Joseee-ctrl/KRAKEN-PCB/Esquematicos_Kraken/fotokraken.png

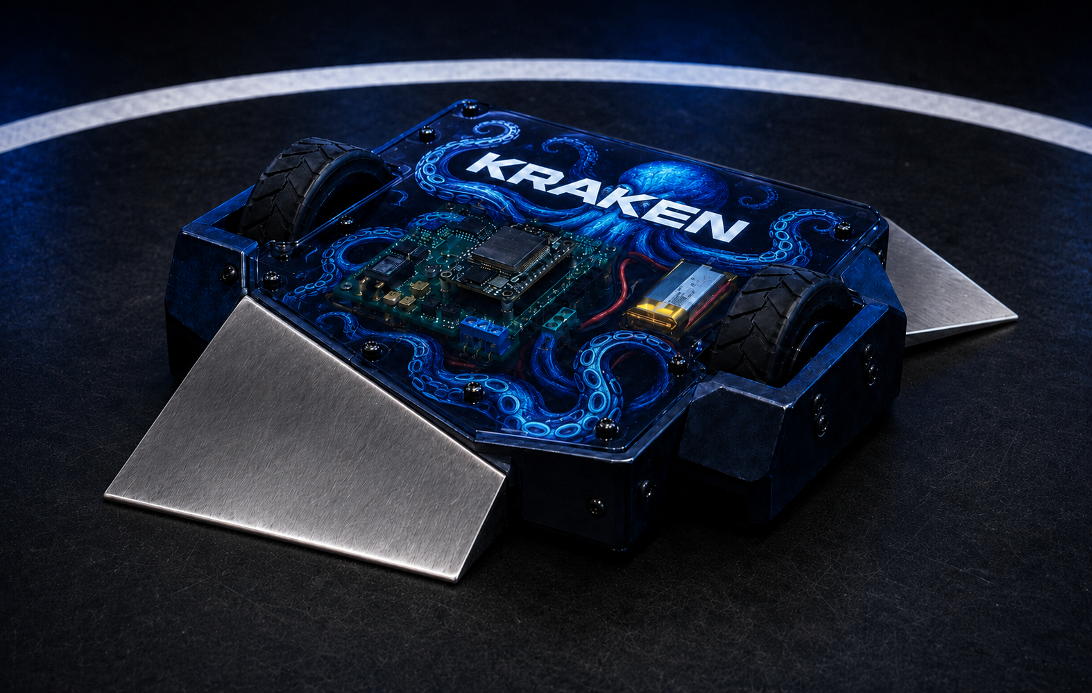
Esquematicos_Kraken/fotokraken.png
