Joseee-ctrl/KRAKEN-PCB/Esquematicos_Kraken/Calculos_esquematicos_pdfs/Reporte_PCB_Kraken.pdf

## Diseño de PCB - Robot Sumo Kraken

Simulación de Circuitos y PCB

Jose Martínez
Carné: 24050

Septiembre de 2026

## 1. Introducción

En esta etapa se realizó el diseño final de la PCB del robot sumo Kraken en Altium Designer. El diseño parte de los esquemáticos desarrollados previamente para los módulos de potencia, control BLE y driver de motores. En este documento se presentan únicamente las decisiones principales del layout, las reglas de fabricación, la verificación y los archivos de salida, evitando repetir la descripción completa de los esquemáticos.

## 2. Diseño de la PCB

La placa final tiene dimensiones de aproximadamente 105 mm × 75 mm. Los componentes se distribuyeron buscando recorridos simples entre alimentación, control y motores. Todo el ruteo se realizó en Bottom Layer, siguiendo la recomendación de fabricación para facilitar el proceso de soldadura. También se agregaron cuatro puntos de montaje de 3 mm en las esquinas.

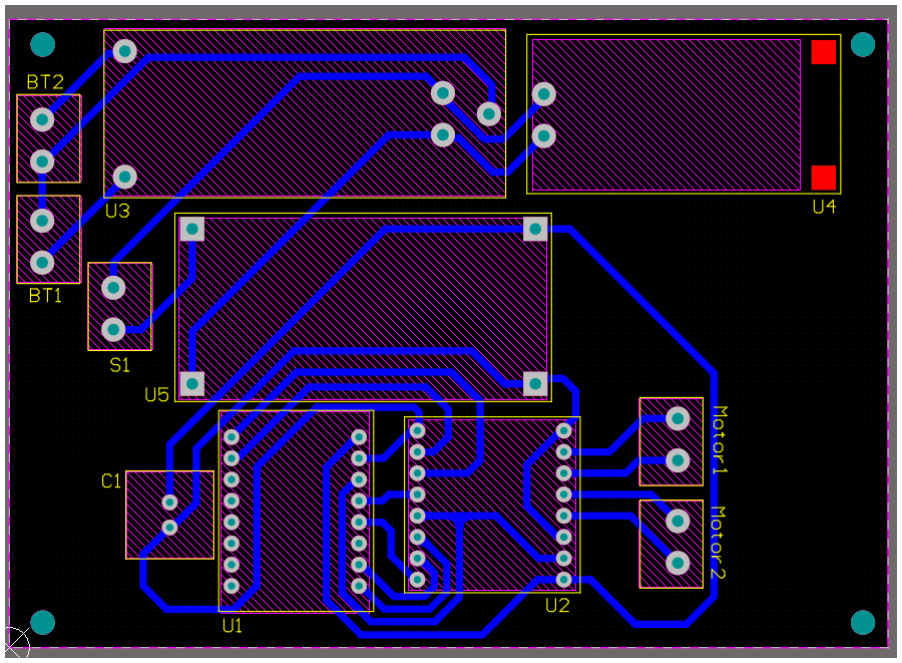
[picture p22: figure]

Figura 1: Layout final de la PCB del robot Kraken.

Todos los footprints incluyen arte en silkscreen y se verificó la posición de los módulos mediante sus modelos 3D. La vista 3D permitió comprobar la orientación de conectores, borneras y módulos antes de generar los archivos de fabricación.

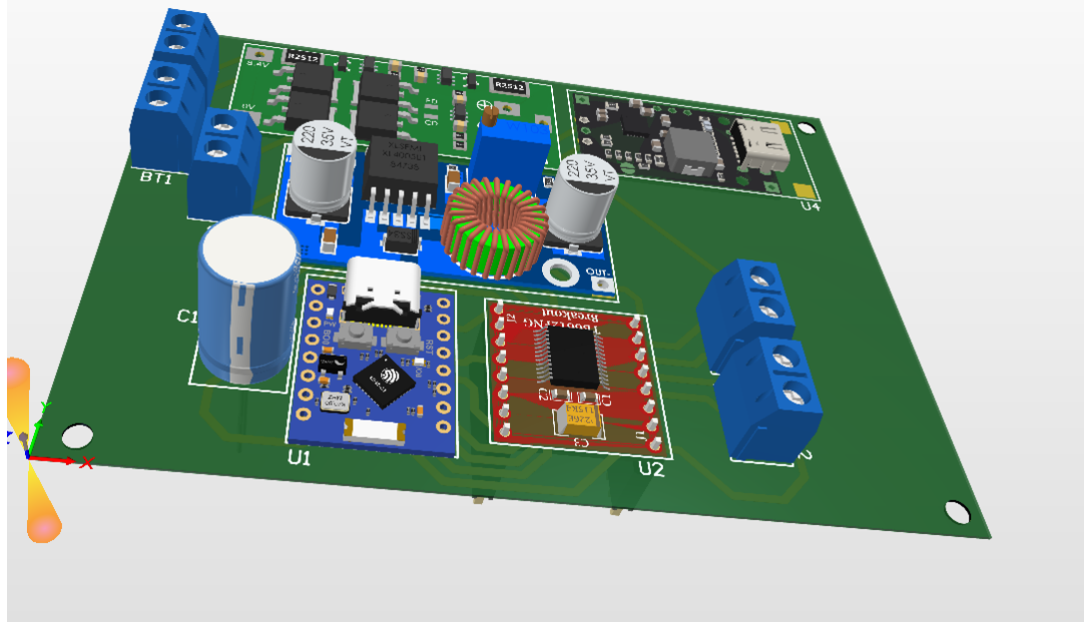
[picture p23: figure]

Figura 2: Vista 3D del diseño final.

## 3. Reglas de diseño

Las reglas se configuraron de acuerdo con los requerimientos del proyecto y con las especificaciones de la fresadora ProtoMat S103. La Tabla 1 resume los valores principales utilizados.

Cuadro 1: Reglas principales del diseño.

Parámetro | Valor utilizado
Dimensiones de la placa | 105 mm × 75 mm
Ancho de pista | 1.0 mm (≈ 39.4 mil)
Clearance | 0.508 mm
Anillo anular mínimo | 0.254 mm
Agujeros de componentes | 1.0 mm y 1.5 mm
Agujeros de montaje | 3.0 mm, NPTH
Capas de ruteo | Bottom Layer

El ancho de 1.0 mm se mantuvo en las pistas del diseño para facilitar la fabricación y soldadura, además de proporcionar margen respecto a los mínimos calculados para las corrientes del sistema.

## 4. Cálculo de ancho de pista

Se utilizó la calculadora ANSI PCB Trace Width basada en IPC-2221A, considerando cobre de 1 oz y un aumento máximo de temperatura de 10◦C.

Para una corriente de 1 A, correspondiente al caso de un motor, el ancho requerido para una pista externa fue de 12.13 mil (≈ 0.31 mm).

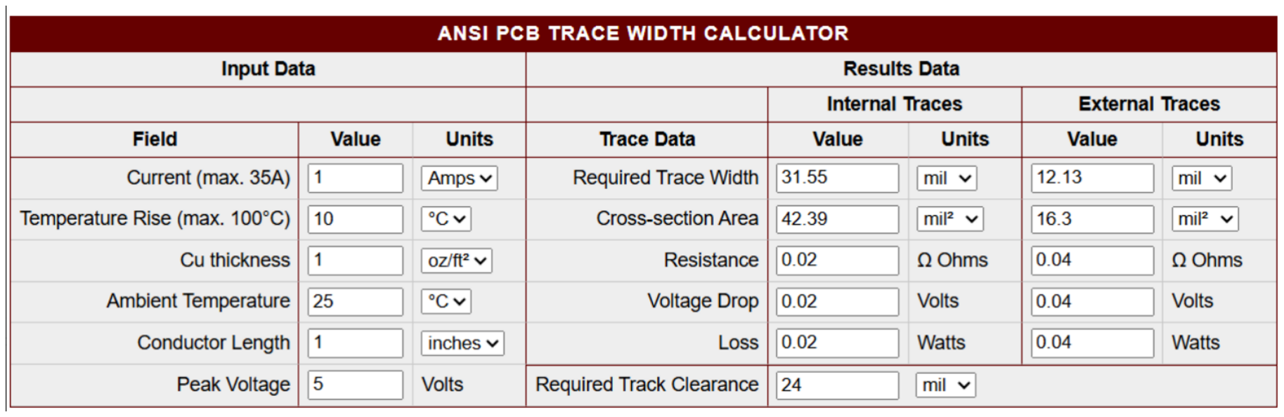
[picture p24: figure]

Figura 3: Cálculo de ancho de pista para 1 A.

Para una corriente de 2 A, utilizada como caso de alimentación común, el ancho requerido fue de 31.55 mil (≈ 0.80 mm). Por lo tanto, el ancho utilizado de 1.0 mm cumple con ambos casos.

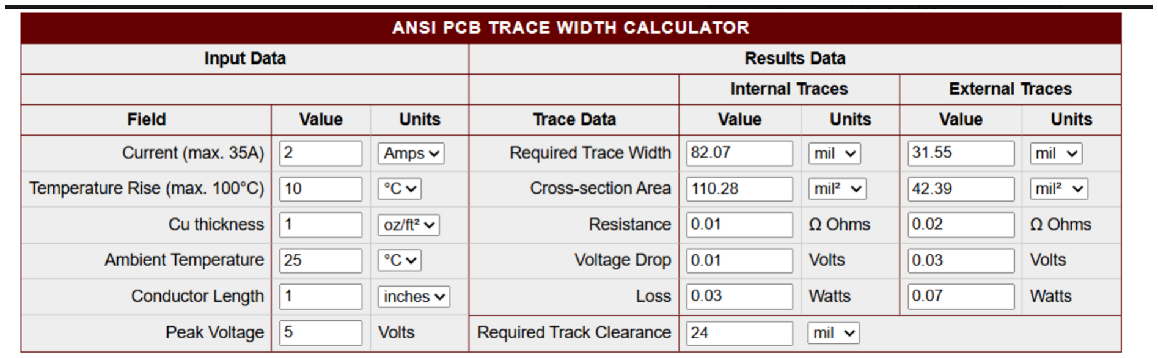
[picture p25: figure]

Figura 4: Cálculo de ancho de pista para 2 A.

## 5. Verificación del diseño

Después de finalizar el ruteo y agregar los puntos de montaje se ejecutó el Design Rule Check de Altium Designer. El reporte final mostró 0 warnings y 0 rule violations, confirmando que el diseño cumple las reglas configuradas de clearance, ancho de pista, agujeros y manufactura.

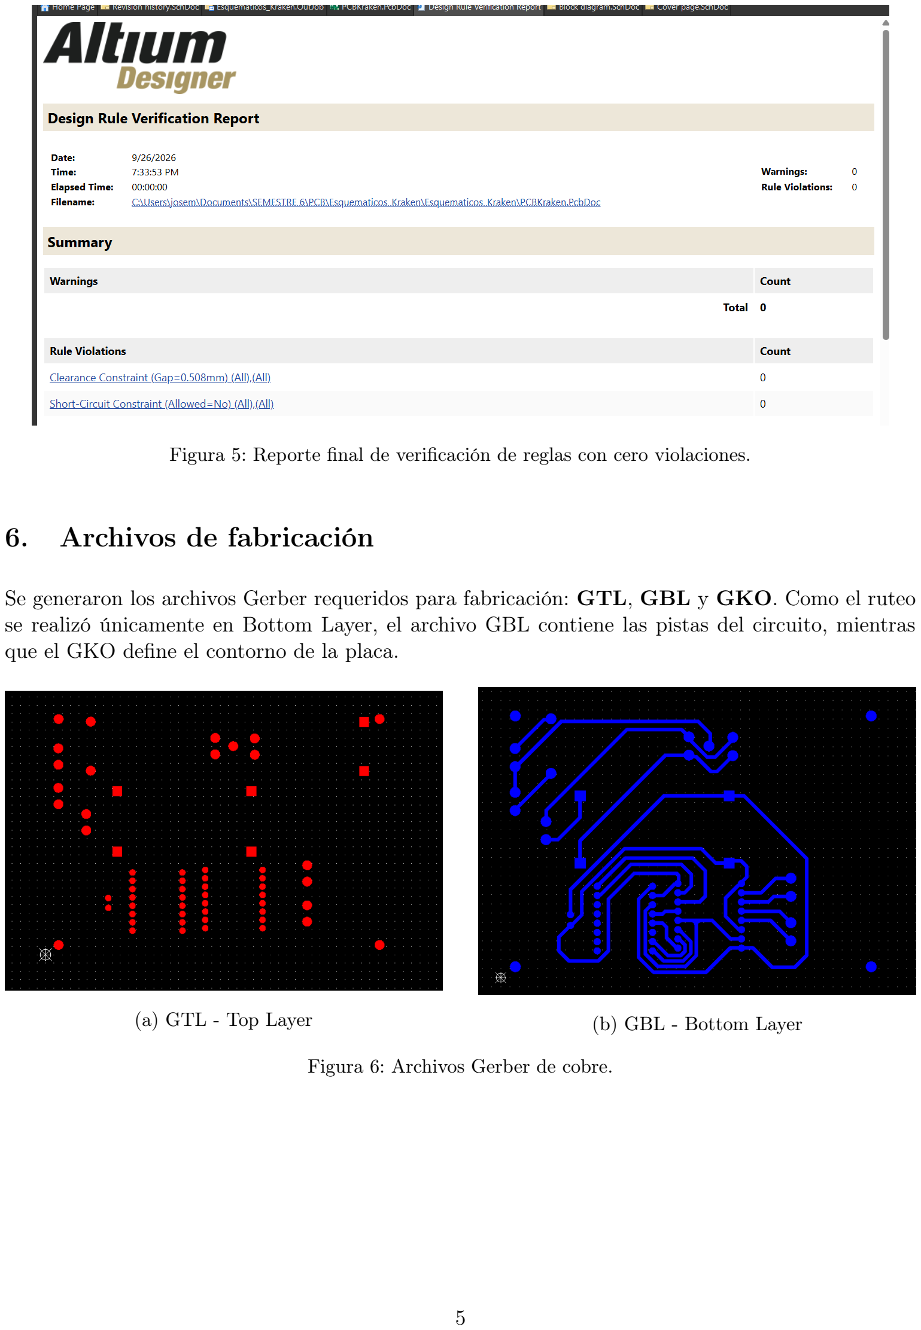
[picture p26: page 5]

Figura 5: Reporte final de verificación de reglas con cero violaciones.

## 6. Archivos de fabricación

Se generaron los archivos Gerber requeridos para fabricación: GTL, GBL y GKO. Como el ruteo se realizó únicamente en Bottom Layer, el archivo GBL contiene las pistas del circuito, mientras que el GKO define el contorno de la placa.

(a) GTL - Top Layer | (b) GBL - Bottom Layer

Figura 6: Archivos Gerber de cobre.

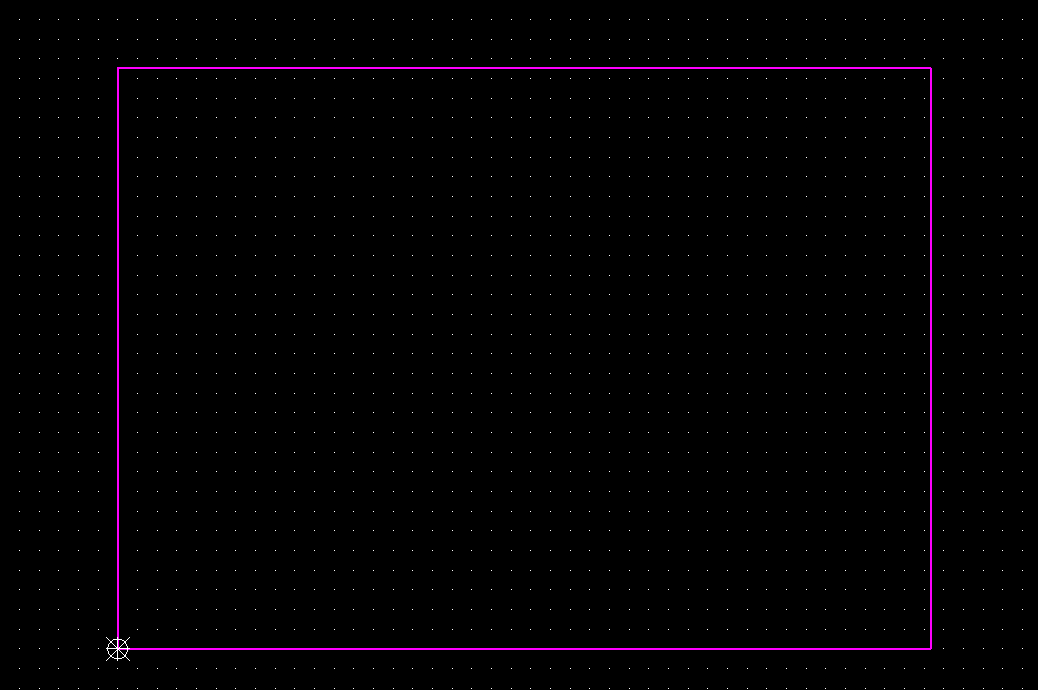
[picture p27: figure]

Figura 7: Archivo GKO con el contorno de la placa.

También se generaron dos archivos NC Drill separados: uno para los agujeros metalizados de los componentes y otro para los agujeros de montaje no metalizados.

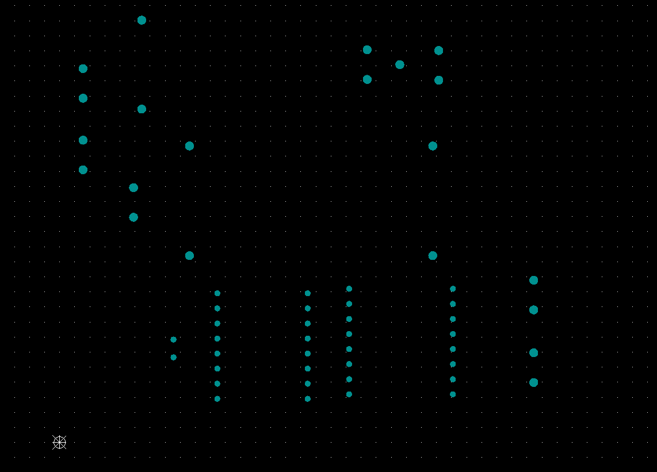
[picture p28: figure]

(a) Agujeros plated

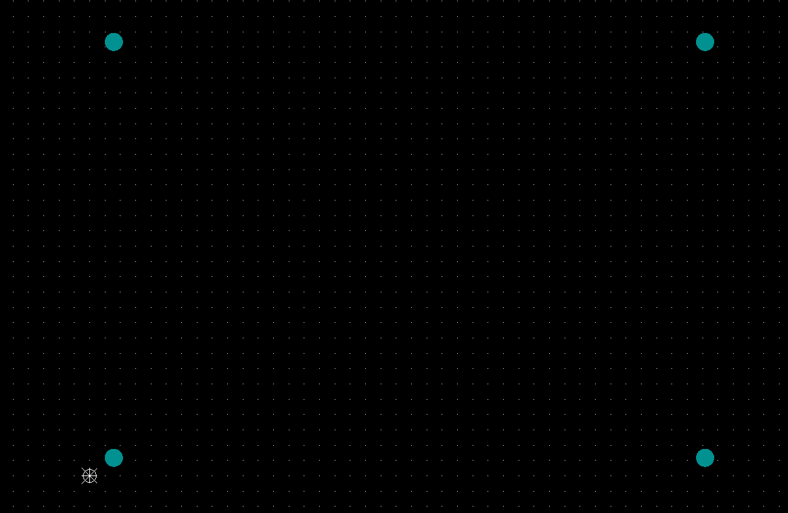
[picture p29: figure]

(b) Agujeros NPTH de montaje

Figura 8: Archivos NC Drill del diseño.

## 7. Encapsulado propuesto

La PCB se montará dentro del chasis del robot utilizando los cuatro puntos de montaje agregados en las esquinas. Se utilizarán separadores para evitar que las soldaduras de la cara inferior tengan contacto con la estructura. El montaje deberá mantener accesibles las borneras, el interruptor y el conector USB-C del cargador.

## 8. Conclusiones

Se completó el diseño final de la PCB del robot Kraken con ruteo en una sola cara, footprints con modelos 3D y reglas adaptadas a la ProtoMat S103. Los cálculos de ancho de pista justifican el valor utilizado y el DRC final no presentó violaciones. Finalmente, se generaron los archivos Gerber y NC Drill requeridos para fabricación.

## Referencias

1. Universidad del Valle de Guatemala. IE3028 - Proyecto de Curso, 2026.
2. Universidad del Valle de Guatemala. Especificaciones LPKF ProtoMat S103.
3. ANSI IPC-2221A PCB Trace Width Calculator.
4. Esquemáticos Kraken, documentación previa del proyecto.
