Joseee-ctrl/KRAKEN-PCB/Esquematicos_Kraken/Project Outputs for Esquematicos_Kraken/Esquematicos_Kraken.xls

Sheet: BOM Report
Bill of Materials |  |  | Bill of Materials for BOM Document [Esquematicos_Kraken.BomDoc]
Source Data From: |  | Esquematicos_Kraken.BomDoc
Project: |  | Esquematicos_Kraken.PrjPcb
Variant: |  | None
Creation Date: | 9/7/2026 | 10:59 AM
Print Date: | 2026-09-07 | 11:00:01
Footprint | Name | LibRef | Designator | Description | Quantity
BAT-2 | Battery | Battery | BT1, BT2 | Multicell Battery | 2
RB7.6-15 | Cap Pol1 | Cap Pol1 | C1 | Polarized Capacitor (Radial) | 1
RAD-0.3 | Cap | Cap | C2, C3 | Capacitor | 2
RB5-10.5 | Motor | Motor | M1, M2 | Motor N20 6V 300 RPM | 2
SPST-2 | SW-SPST | SW-SPST | S1 | Single-Pole, Single-Throw Switch | 1
 | ESP32-C3 SUPERMINI | ESP32-C3 SUPERMINI | U1 | ESP32-C3 SUPERMINI V1.0 | 1
 | TB6612FNG devkit v1.0 | TB6612FNG devkit v1.0 | U2 | TB6612FNG devkit v1.0 | 1
 | BMS 2S 20A | BMS 2S 20A | U3 | BMS 2S 20A v1.0 | 1
 | CARGADOR 2S USB-C | CARGADOR 2S USB-C | U4 | CARGADOR 2S USB-C v1.0 | 1
 | XL4005 | XL4005_MODULE | U5 | XL4005_MODULE | 1
 |  |  |  |  | 13
Approved |  | Notes

Sheet: Project Information
Project Full Path | C:\Users\josem\Documents\SEMESTRE 6\PCB\Esquematicos_Kraken\Esquematicos_Kraken\Esquematicos_Kraken.PrjPcb
Project Filename | Esquematicos_Kraken.PrjPcb
Variant Name | None
Data-Source Filename | Esquematicos_Kraken.BomDoc
Data-Source Full Path | C:\Users\josem\Documents\SEMESTRE 6\PCB\Esquematicos_Kraken\Esquematicos_Kraken\Esquematicos_Kraken.BomDoc
Title | Bill of Materials for BOM Document [Esquematicos_Kraken.BomDoc]
Total Quantity | 13
Report Time | 10:59 AM
Report Date | 9/7/2026
Report Date & Tine | 9/7/2026 10:59 AM
Output Name | Bill of Materials
Output Type | BomReport
Output Generator Name | BOM
Output Generator Description | Bill of Materials
