Joseee-ctrl/KRAKEN-PCB/Esquematicos_Kraken/Project Outputs for Esquematicos_Kraken/Esquematicos_Kraken.xlsx

Name | Description | Designator | LibRef | Supplier | Value | SKU | Precio unitario (Q)
Battery | Multicell Battery | BT1, BT2 | Battery | DIY ELECTRONICA |  | T35 | 55
Cap Pol1 | Polarized Capacitor (Radial) | C1 | Cap Pol1 | DIY ELECTRONICA | 1000uF | K510-1 | 4.5
Cap | Capacitor | C2, C3 | Cap | DIY ELECTRONICA | 100nF | K305-1 | 0.5
Motor | Motor N20 6V 300 RPM | M1, M2 | Motor | DIY ELECTRONICA |  | M225 | 44
SW-SPST | Single-Pole, Single-Throw Switch | S1 | SW-SPST | DIY ELECTRONICA |  | M234 | 6
ESP32-C3 SUPERMINI | ESP32-C3 SUPERMINI V1.0 | U1 | ESP32-C3 SUPERMINI | DIY ELECTRONICA |  | B207 | 75
TB6612FNG devkit v1.0 | TB6612FNG devkit v1.0 | U2 | TB6612FNG devkit v1.0 | DIY ELECTRONICA |  | I235 | 45
BMS 2S 20A | BMS 2S 20A v1.0 | U3 | BMS 2S 20A | DIY ELECTRONICA |  | I239 | 29.5
CARGADOR 2S USB-C | CARGADOR 2S USB-C v1.0 | U4 | CARGADOR 2S USB-C | DIY ELECTRONICA |  | I232 | 15
XL4005 | XL4005_MODULE | U5 | XL4005_MODULE | DIY ELECTRONICA |  | I26 | 30
