Joseee-ctrl/KRAKEN-PCB/Esquematicos_Kraken/modelo/paredes 2 kraken.dxf

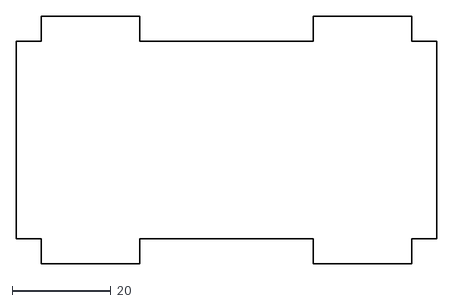
[picture p30: CAD file, 2026-10-31]
Esquematicos_Kraken/modelo/paredes 2 kraken.dxf
85.0 x 50.0
