Joseee-ctrl/KRAKEN-PCB/Esquematicos_Kraken/Steps/XL4005_MODELO_3D_1.step

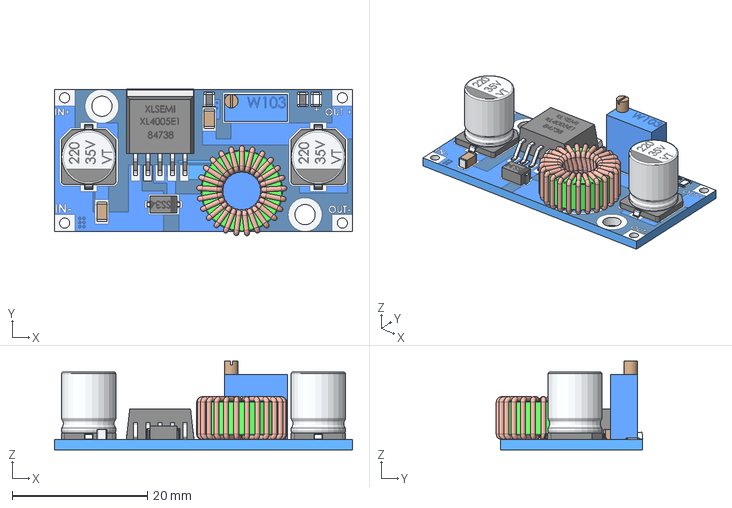
[picture p31: CAD file, 2026-10-31]
Esquematicos_Kraken/Steps/XL4005_MODELO_3D_1.step
44.0 x 21.6 x 13.1 mm
