Joseee-ctrl/KRAKEN-PCB/Esquematicos_Kraken/modelo/cuñas kraken.dxf

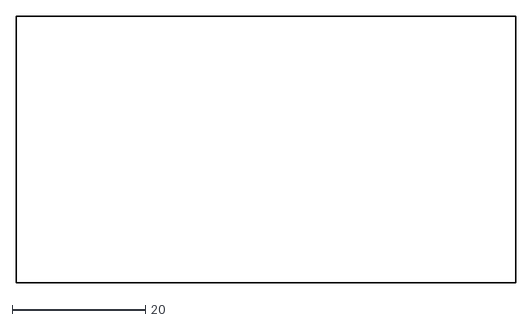
[picture p32: CAD file, 2026-10-31]
Esquematicos_Kraken/modelo/cuñas kraken.dxf
75.0 x 40.0
