Joseee-ctrl/KRAKEN-PCB/Esquematicos_Kraken/Steps/Terminal block 5mm.step

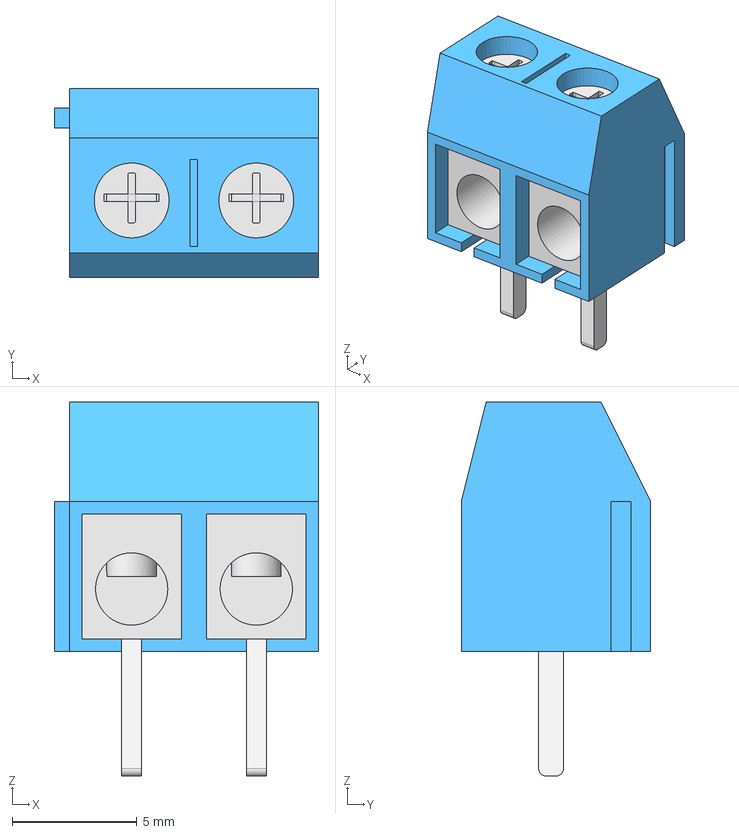
[picture p33: CAD file, 2026-10-31]
Esquematicos_Kraken/Steps/Terminal block 5mm.step
10.6 x 7.60 x 15.0 mm
Tornillos001
