Joseee-ctrl/KRAKEN-PCB/Esquematicos_Kraken/modelo/baseNUEVAkraken.dxf

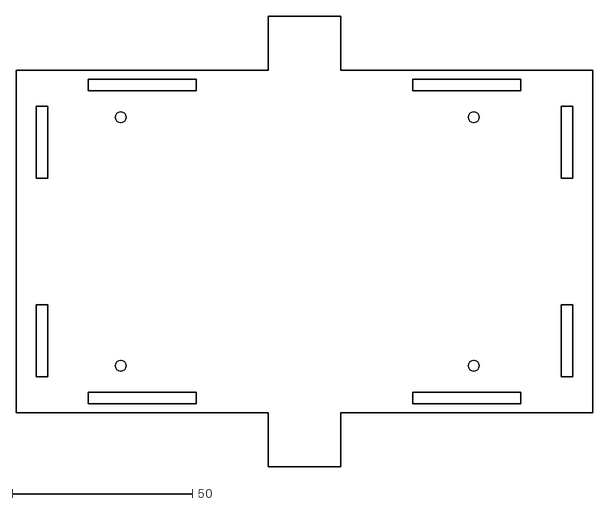
[picture p34: CAD file, 2026-10-31]
Esquematicos_Kraken/modelo/baseNUEVAkraken.dxf
160.0 x 125.0
