Joseee-ctrl/KRAKEN-PCB/Esquematicos_Kraken/Steps/switch.step

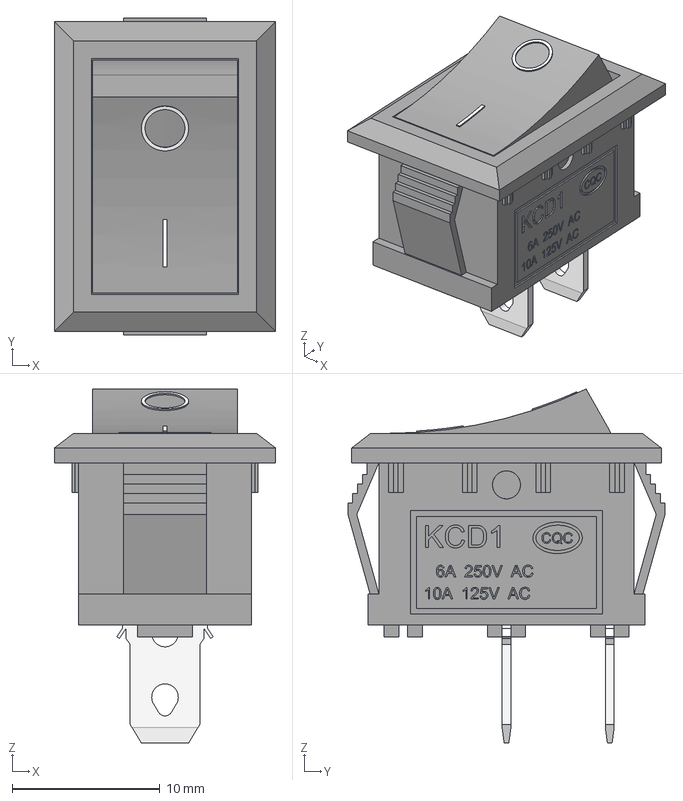
[picture p35: CAD file, 2026-10-31]
Esquematicos_Kraken/Steps/switch.step
15.0 x 21.5 x 24.0 mm
Blade_001
Blade_002
Base_w_text
knob001
