Joseee-ctrl/KRAKEN-PCB/Esquematicos_Kraken/modelo/paredes 1 kraken.dxf

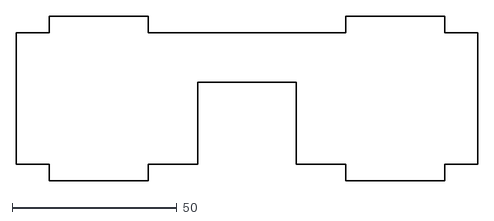
[picture p36: CAD file, 2026-10-31]
Esquematicos_Kraken/modelo/paredes 1 kraken.dxf
140.0 x 50.0
