Joseee-ctrl/KRAKEN-PCB/Esquematicos_Kraken/Steps/cargador2.step

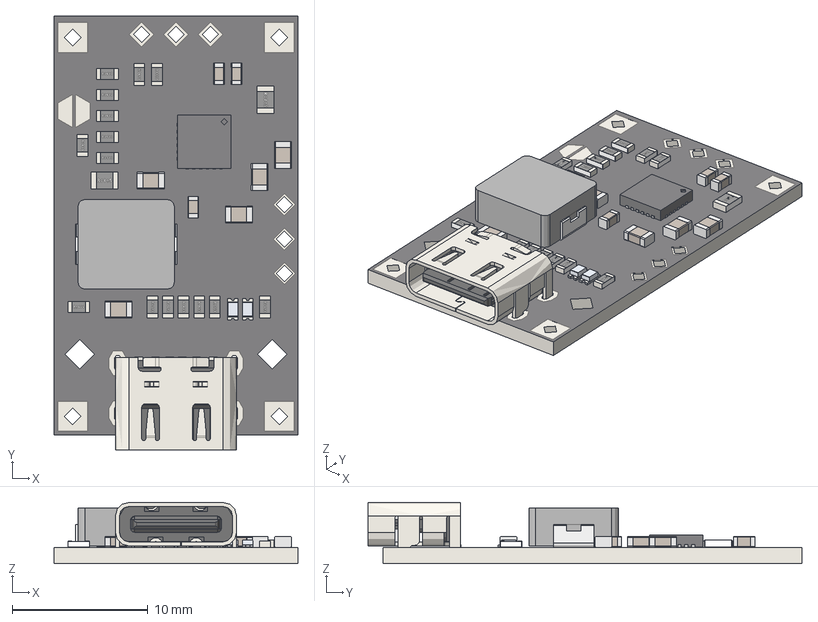
[picture p37: CAD file, 2026-10-31]
Esquematicos_Kraken/Steps/cargador2.step
18.0 x 32.0 x 4.51 mm
