Joseee-ctrl/KRAKEN-PCB/Esquematicos_Kraken/modelo/basekraken.dxf

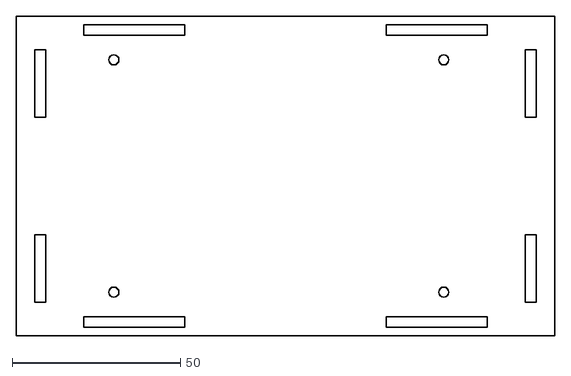
[picture p38: CAD file, 2026-10-31]
Esquematicos_Kraken/modelo/basekraken.dxf
160.0 x 95.0
