Joseee-ctrl/KRAKEN-PCB/Esquematicos_Kraken/Steps/TB6612FNG.step

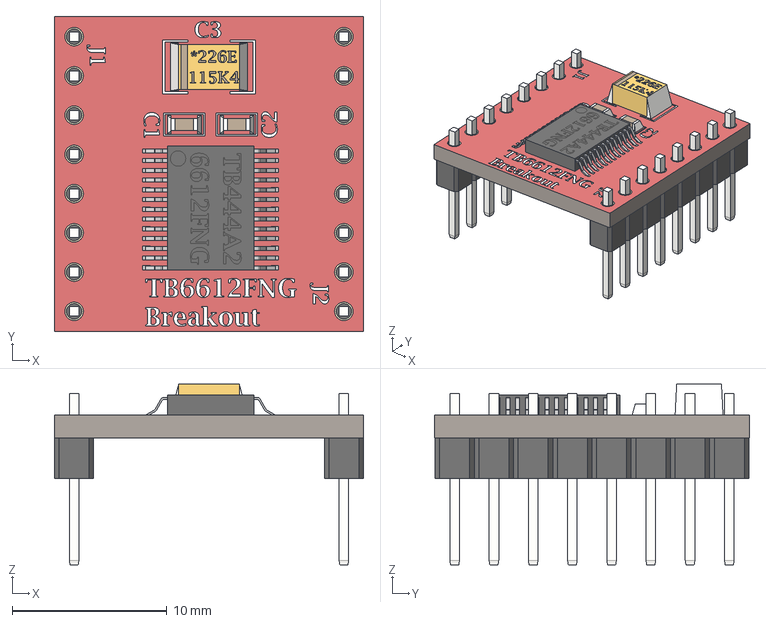
[picture p39: CAD file, 2026-10-31]
Esquematicos_Kraken/Steps/TB6612FNG.step
20.0 x 20.4 x 11.7 mm
8x1 male header pins x 2
