Joseee-ctrl/KRAKEN-PCB/Esquematicos_Kraken/modelo/cuñas Copy 1 - Part 1.dxf

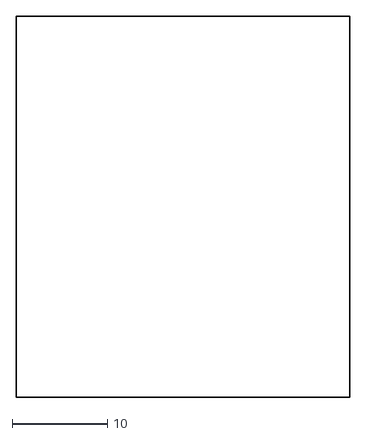
[picture p40: CAD file, 2026-10-31]
Esquematicos_Kraken/modelo/cuñas Copy 1 - Part 1.dxf
35.0 x 40.0
