Joseee-ctrl/KRAKEN-PCB/Esquematicos_Kraken/Steps/bornera2p.step

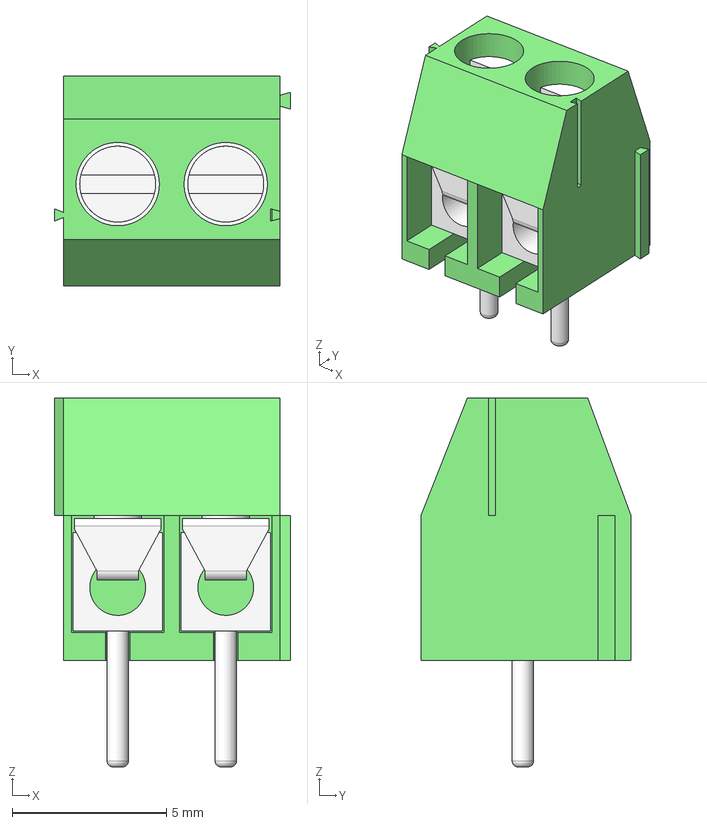
[picture p41: CAD file, 2026-10-31]
Esquematicos_Kraken/Steps/bornera2p.step
7.65 x 6.80 x 11.9 mm
Corps
Conn_1
Conn_2
blade_1
blade_2
Vis_1
Vis_001
