Joseee-ctrl/KRAKEN-PCB/Esquematicos_Kraken/Steps/HW-391 2S 20A BMS.step

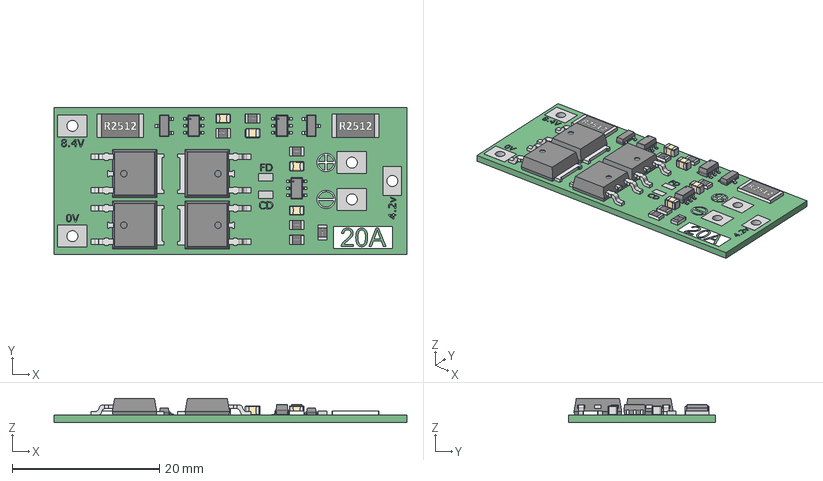
[picture p42: CAD file, 2026-10-31]
Esquematicos_Kraken/Steps/HW-391 2S 20A BMS.step
48.0 x 20.0 x 3.31 mm
