Joseee-ctrl/KRAKEN-PCB/Esquematicos_Kraken/Steps/ESP32-C3-SuperMini.step

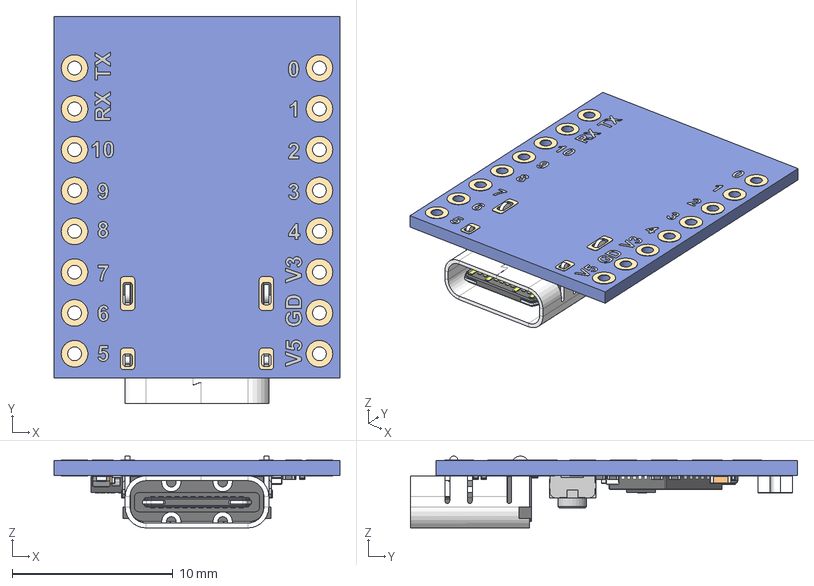
[picture p43: CAD file, 2026-10-31]
Esquematicos_Kraken/Steps/ESP32-C3-SuperMini.step
17.8 x 24.1 x 4.47 mm
