Joseee-ctrl/KRAKEN-PCB/Esquematicos_Kraken/Steps/100uF electrolytic capacitor.step

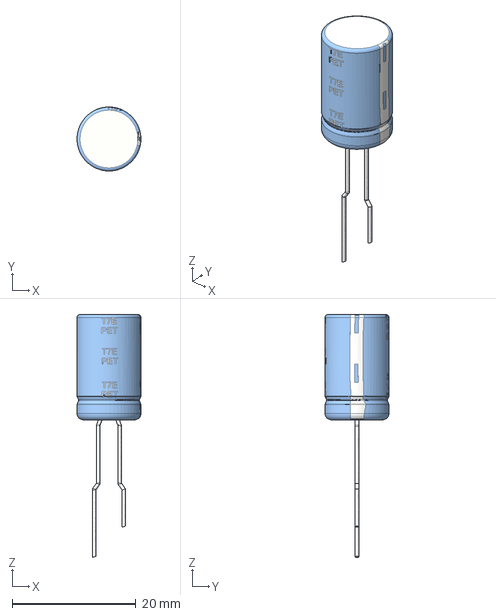
[picture p44: CAD file, 2026-10-31]
Esquematicos_Kraken/Steps/100uF electrolytic capacitor.step
10.3 x 10.3 x 39.3 mm
