Joseee-ctrl/KRAKEN-PCB/Esquematicos_Kraken/modelo/krakenprueba1.pdf

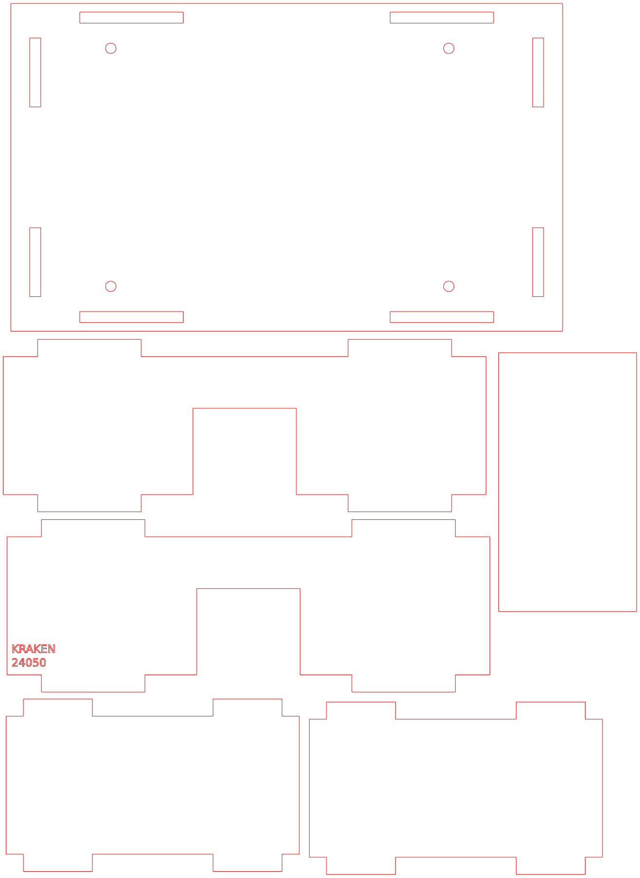
[picture p54: figure]
