Joseee-ctrl/KRAKEN-PCB/Esquematicos_Kraken/Calculos_esquematicos_pdfs/Esquematicos_Kraken.pdf

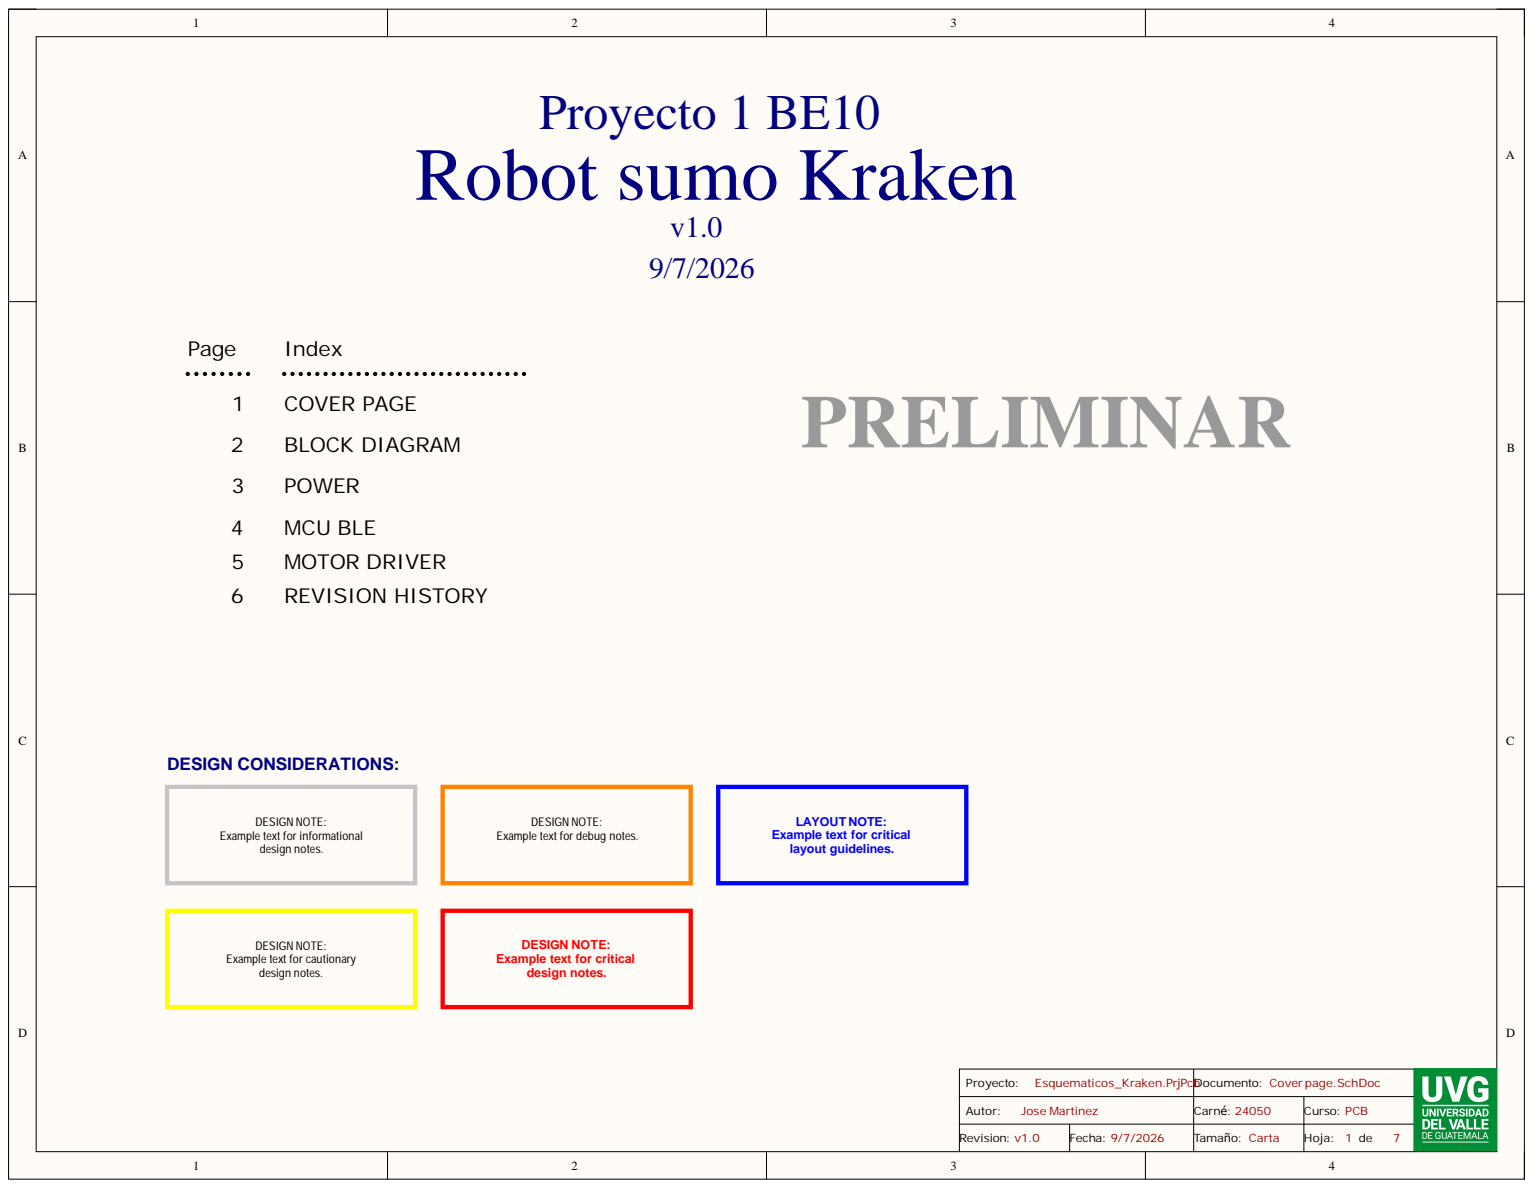
[picture p55: page 1]

LAYOUT NOTE:
Example text for critical
layout guidelines.

Example text for informational

Example text for debug notes.

DESIGN NOTE:
Example text for cautionary

design notes.

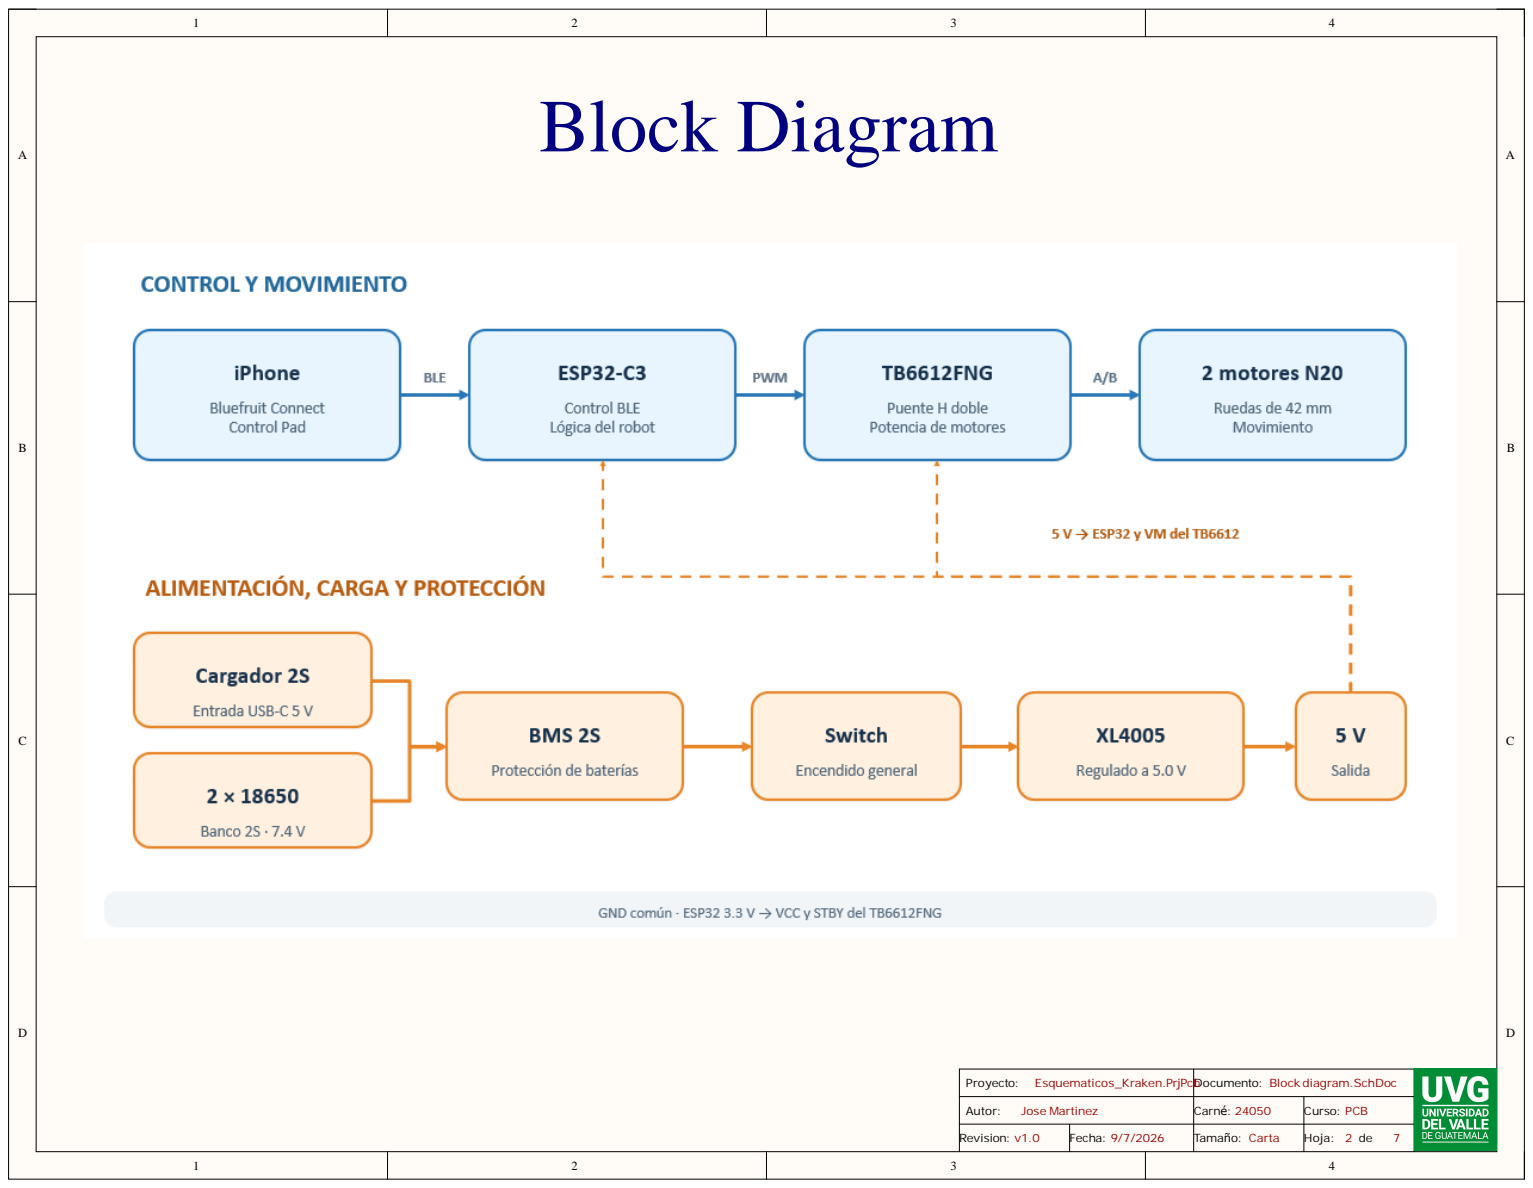
[picture p56: page 2]

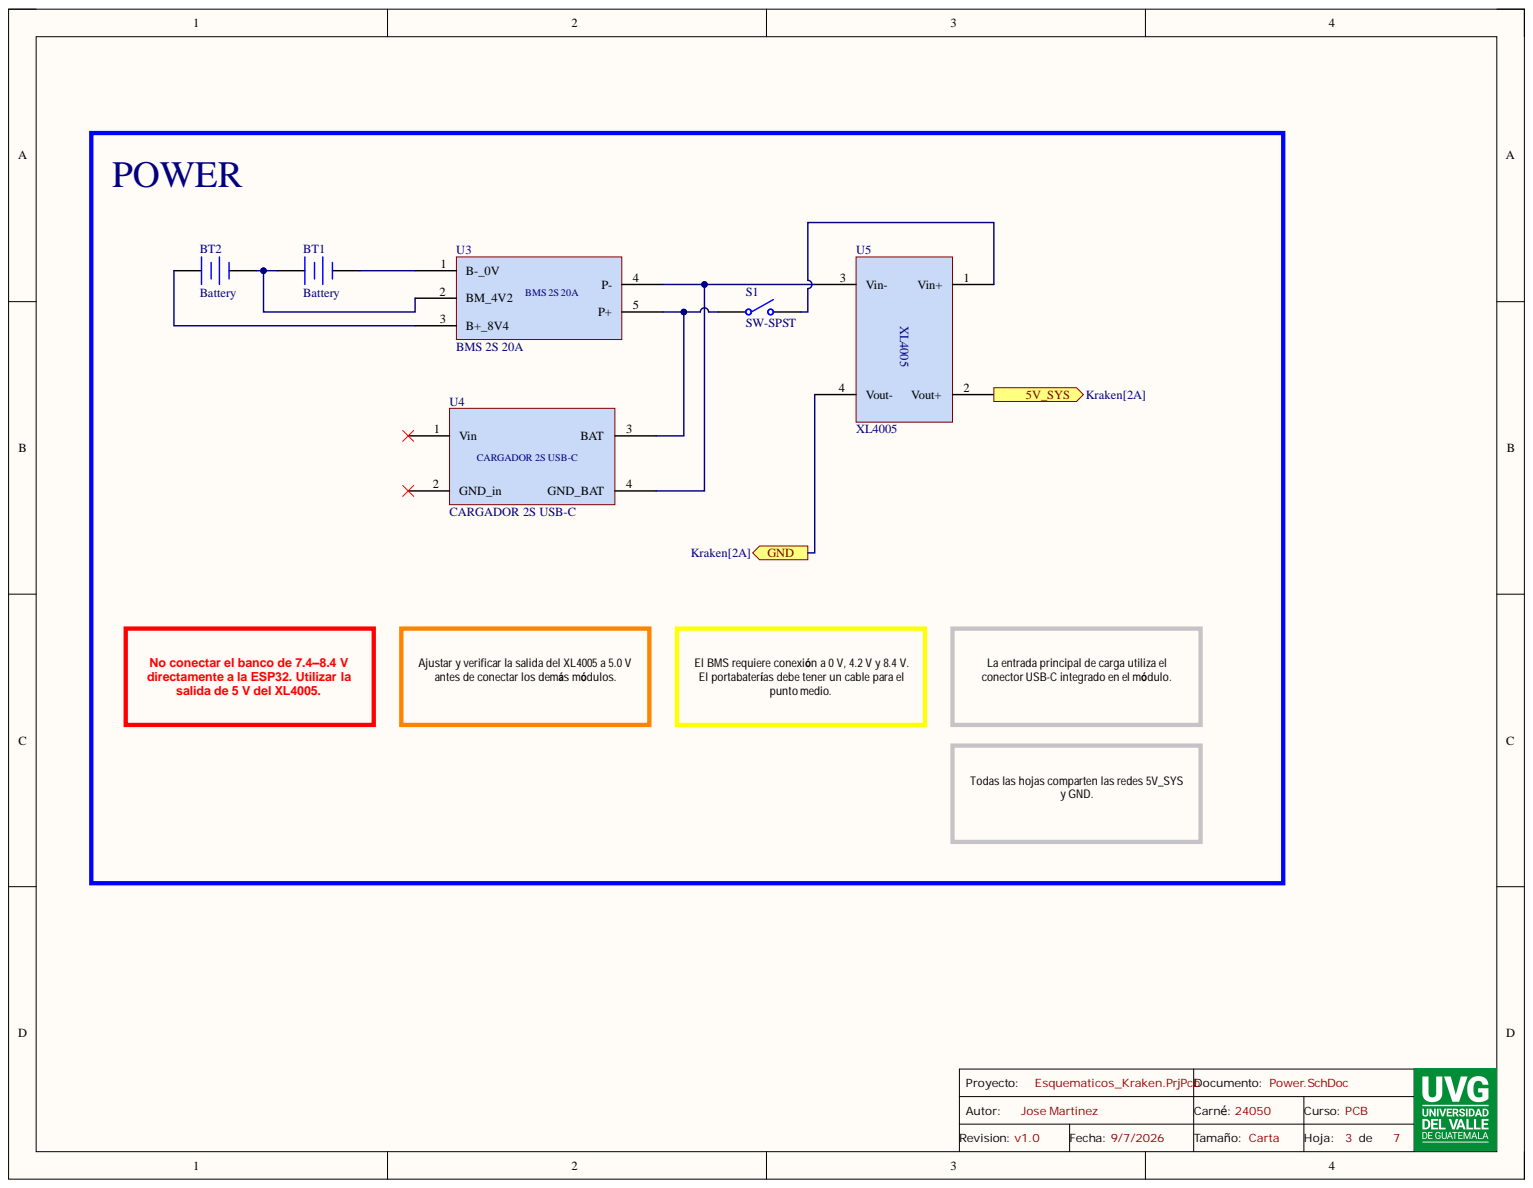
[picture p57: page 3]

No conectar el banco de 7.4–8.4 V
directamente a la ESP32. Utilizar la
salida de 5 V del XL4005.

Ajustar y verificar la salida del XL4005 a 5.0 V
antes de conectar los demás módulos.

El BMS requiere conexión a 0 V, 4.2 V y 8.4 V.
El portabaterías debe tener un cable para el

La entrada principal de carga utiliza el
conector USB-C integrado en el módulo.

Todas las hojas comparten las redes 5V_SYS

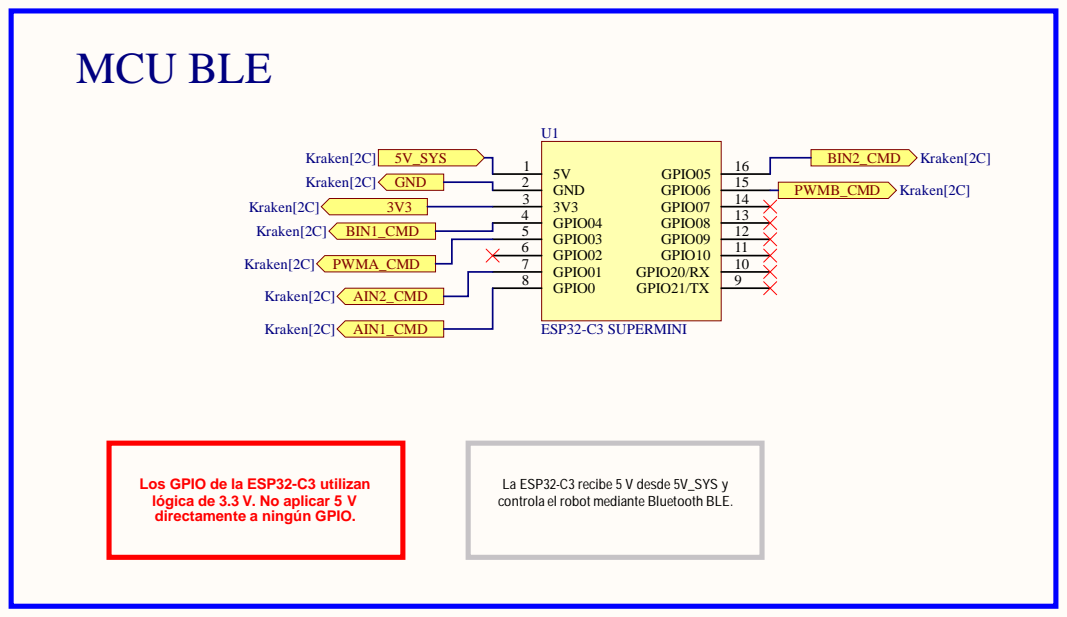
[picture p58: page 4]

GPIO03 5
GPIO02 6

Los GPIO de la ESP32-C3 utilizan
lógica de 3.3 V. No aplicar 5 V
directamente a ningún GPIO.

La ESP32-C3 recibe 5 V desde 5V_SYS y
controla el robot mediante Bluetooth BLE.

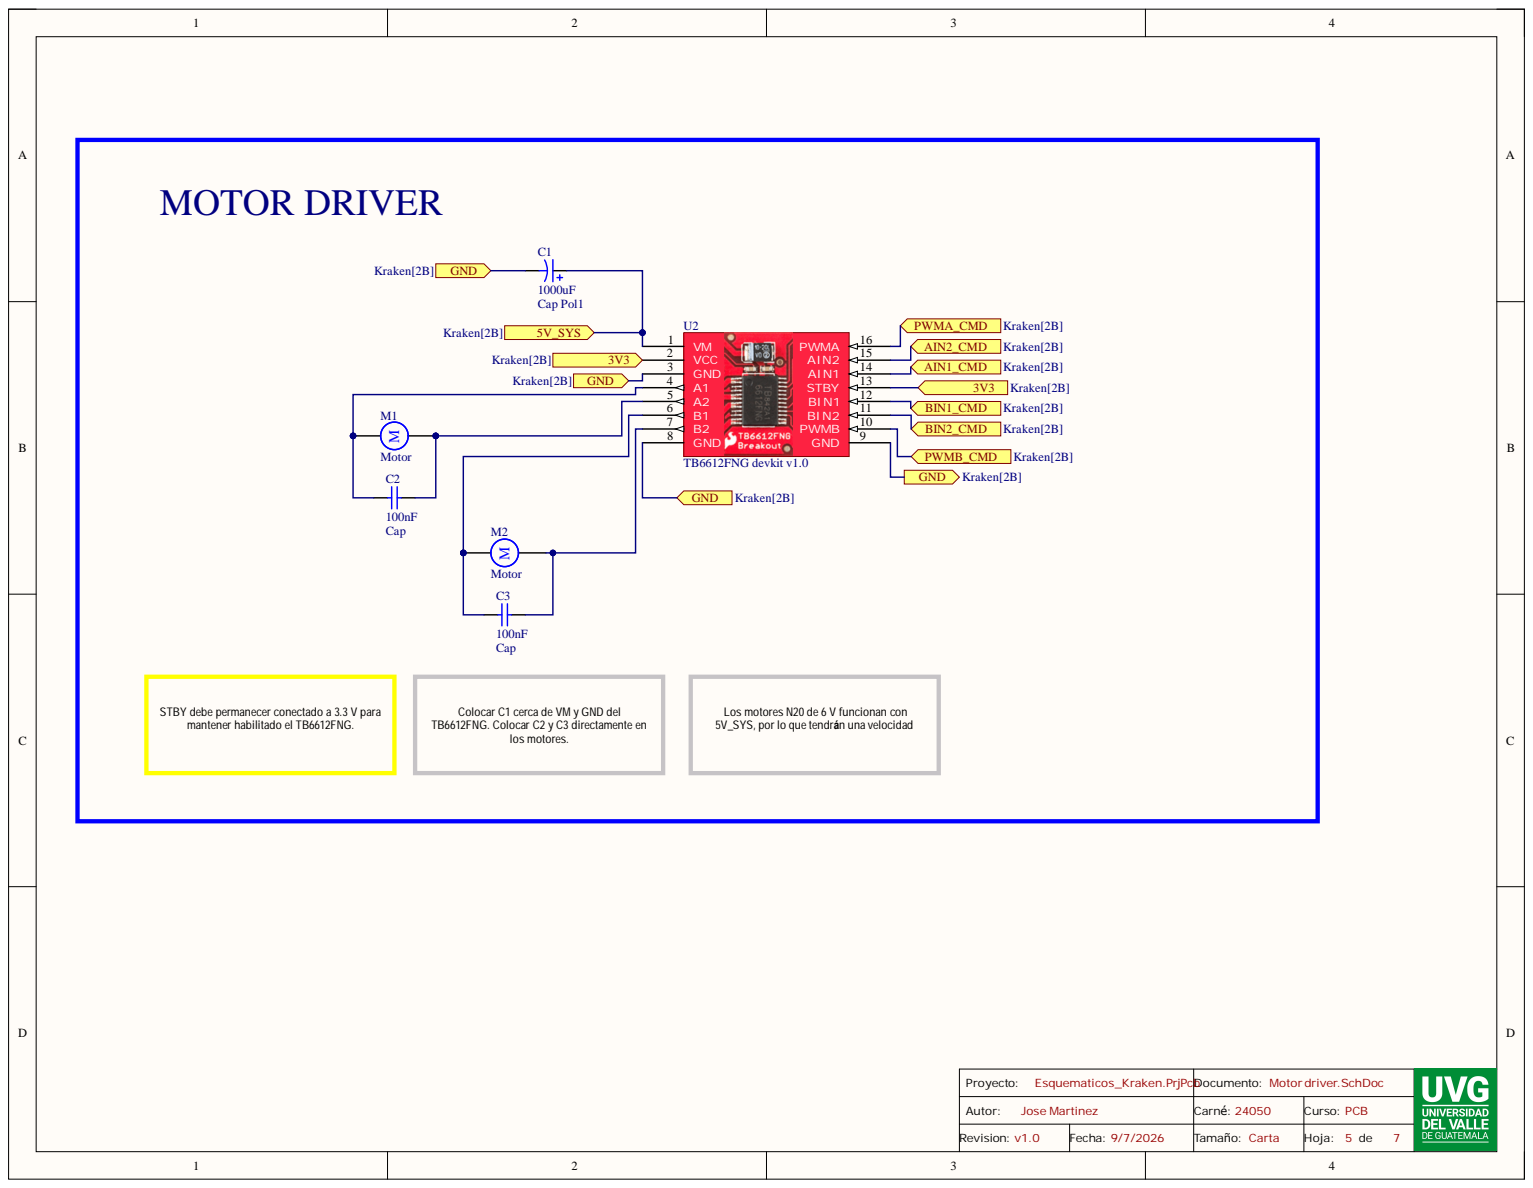
[picture p59: page 5]

A2 5
B1 6
B2 7

Cap

STBY debe permanecer conectado a 3.3 V para
mantener habilitado el TB6612FNG.

Colocar C1 cerca de VM y GND del
TB6612FNG. Colocar C2 y C3 directamente en

Los motores N20 de 6 V funcionan con
5V_SYS, por lo que tendrán una velocidad

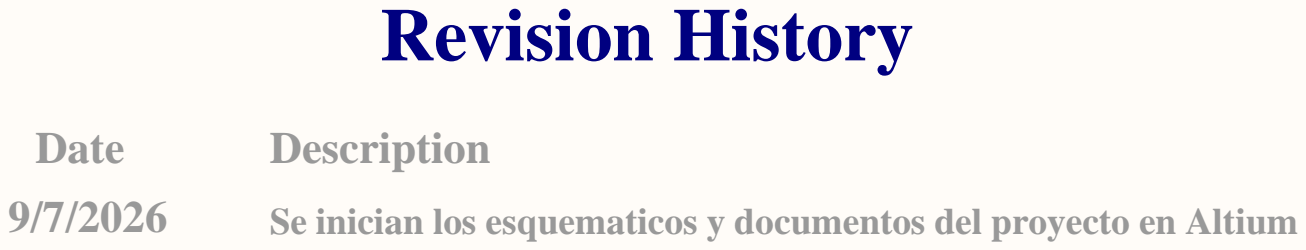
[picture p60: page 6]

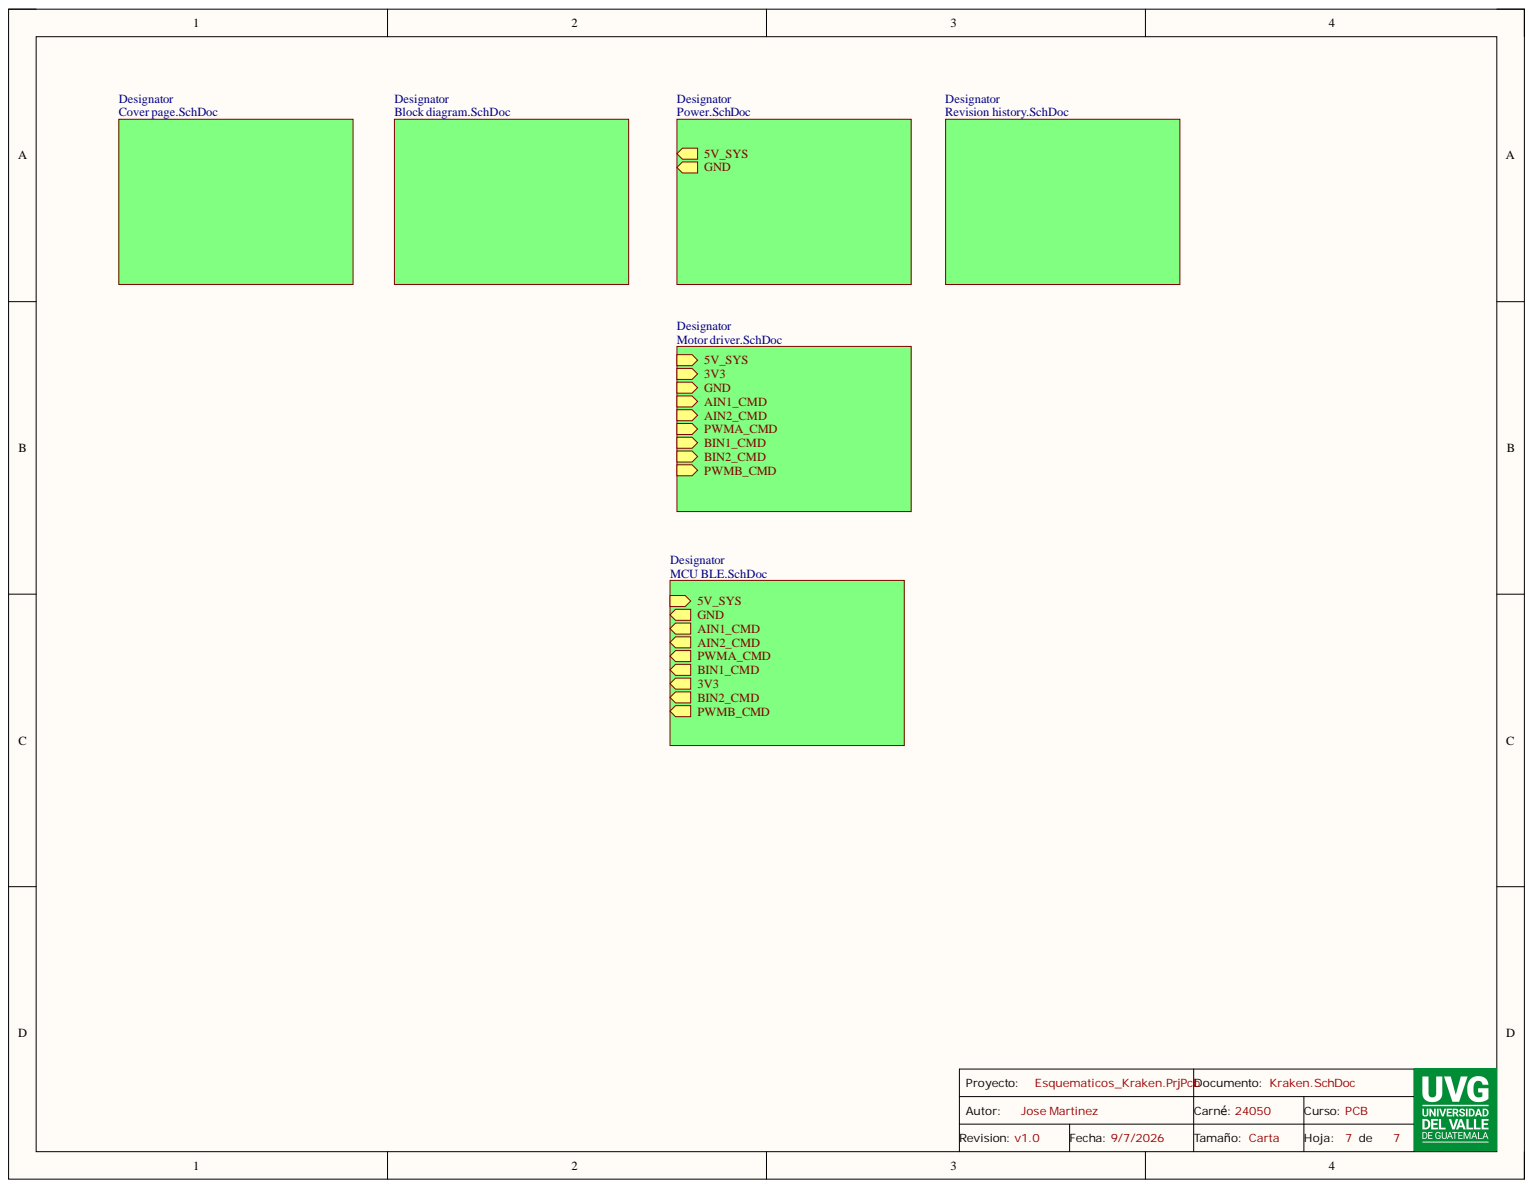
[picture p61: page 7]

Name | Description | Designator | Value | Quantity | Supplier | SKU | Precio unitario (Q) | Subtotal (Q)
Battery | Multicell Battery | BT1, BT2 | | 2 | DIYELECTRONICA | T35 | 55 | 110
BMS2S20A | BMS2S20A v1.0 | U3 | | 1 | DIYELECTRONICA | I239 | 29.5 | 29.5
Cap | Capacitor | C2, C3 | 100nF | 2 | DIYELECTRONICA | K305-1 | 0.5 | 1
CapPol1 | Polarized Capacitor (Radial) | C1 | 1000uF | 1 | DIYELECTRONICA | K510-1 | 4.5 | 4.5
CARGADOR2SUSB-C | CARGADOR2S USB-Cv1.0 | U4 | | 1 | DIYELECTRONICA | I232 | 15 | 15
ESP32-C3SUPERMINI | ESP32-C3 SUPERMINIV1.0 | U1 | | 1 | DIYELECTRONICA | B207 | 75 | 75
Motor | Motor N206V300 RPM | M1, M2 | | 2 | DIYELECTRONICA | M225 | 44 | 88
SW-SPST | Single-Pole, Single-ThrowSwitch | S1 | | 1 | DIYELECTRONICA | M234 | 6 | 6
TB6612FNGdevkit v1.0 | TB6612FNGdevkit v1.0 | U2 | | 1 | DIYELECTRONICA | I235 | 45 | 45
XL4005 | XL4005_MODULE | U5 | | 1 | DIYELECTRONICA | I26 | 30 | 30
Z. TOTALDELPROYECTO | | | | 1 | | | | Q404.00
