Joseee-ctrl/KRAKEN-PCB/(list of files, drawings)

Other design files:
Esquematicos_Kraken/Block diagram.SchDoc
Esquematicos_Kraken/Cover page.SchDoc
Esquematicos_Kraken/Esquematicos_Kraken.PrjPcb
Esquematicos_Kraken/Kraken.SchDoc
Esquematicos_Kraken/KrakenFootprints.PcbLib
Esquematicos_Kraken/MCU BLE.SchDoc
Esquematicos_Kraken/Motor driver.SchDoc
Esquematicos_Kraken/PCBKraken.PcbDoc
Esquematicos_Kraken/Power.SchDoc
Esquematicos_Kraken/Revision history.SchDoc
